xil-se/xilwatch_hw/xilwatch2.pdf

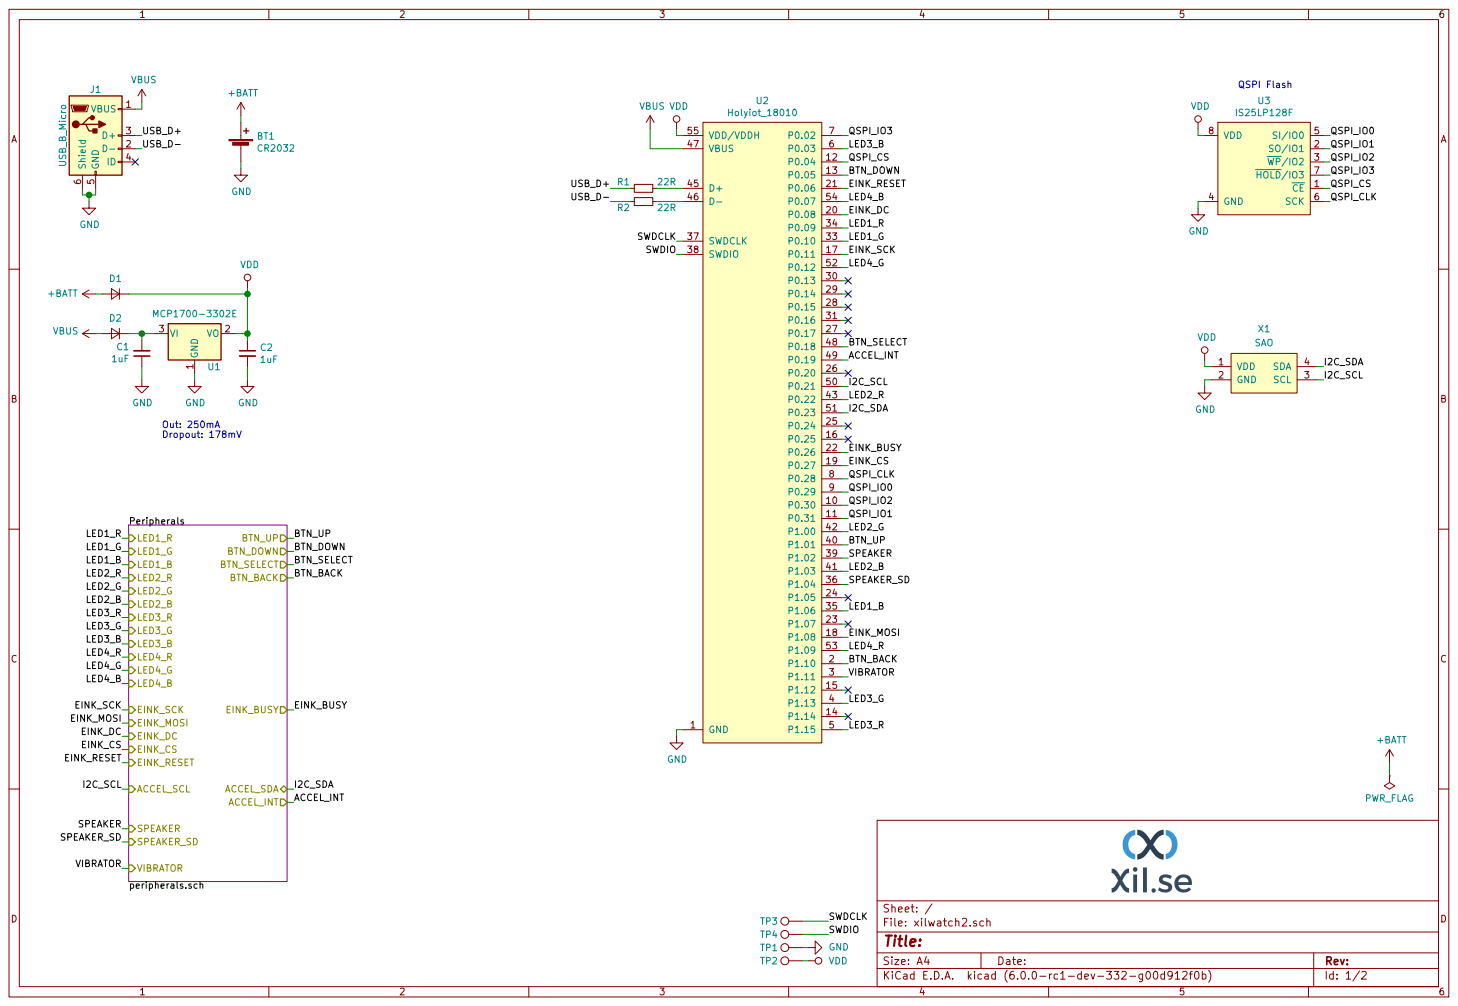
[picture p1: page 1]

Id: 1/2 Title: File: xilwatch2.sch Sheet: / VDD GND
SWDCLK
SWDIO

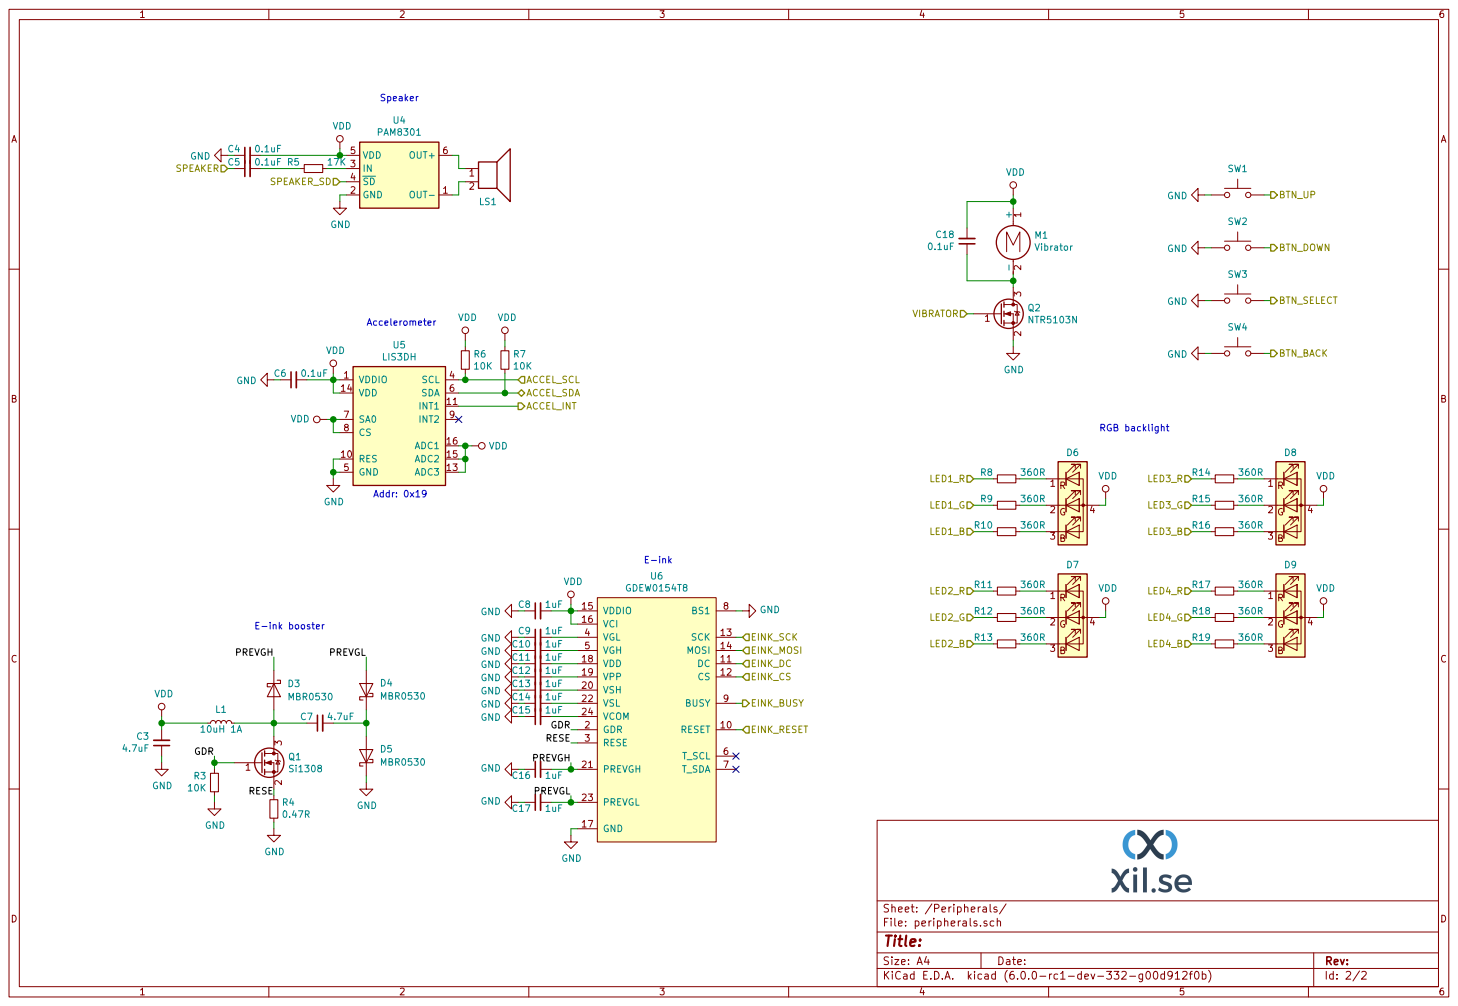
[picture p2: page 2]
