xil-se/xilwatch_hw/xilwatch2.kicad_pcb

## KiCad design xilwatch2.kicad_pcb (2018-09-23)

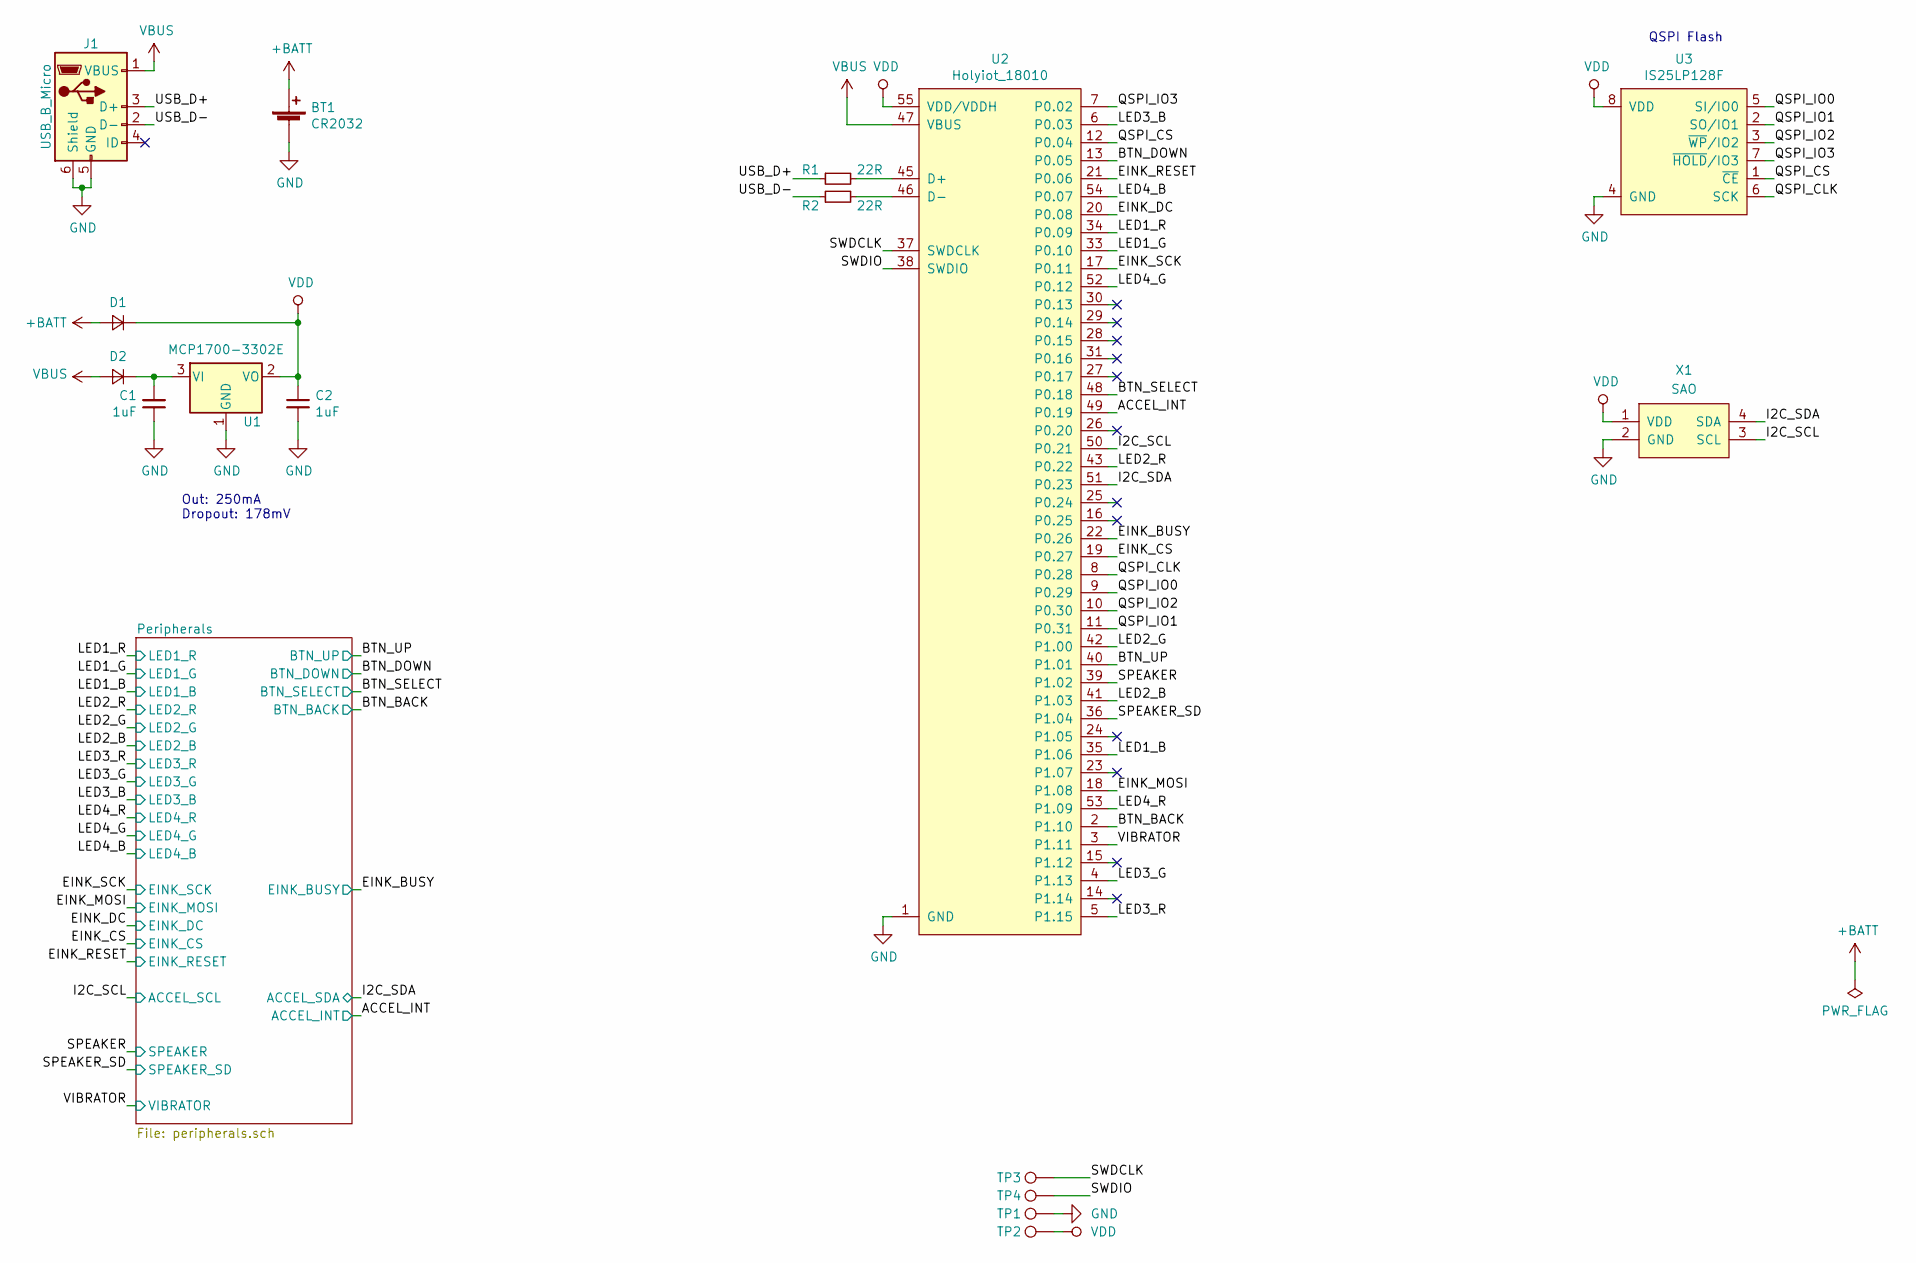
[picture p3: schematic xilwatch2.sch]

Parts:
BT1: CR2032; BAT-HLD-001
C1, C2: 1uF; C_0603_1608Metric
D1, D2: S1JHE; D_SOD-323F
J1: USB_B_Micro; USB_Micro-B_Molex-105017-0001
R1, R2: 22R; R_0603_1608Metric
TP1: TP_GND; TestPoint_Pad_D1.0mm
TP2: TP_VDD; TestPoint_Pad_D1.0mm
TP3: TP_SWDCLK; TestPoint_Pad_D1.0mm
TP4: TP_SWDIO; TestPoint_Pad_D1.0mm
U1: MCP1700-3302E; SOT-23
U2: Holyiot_18010
U3: IS25LP128F; WSON-8-1EP_6x5mm_P1.27mm_EP3.4x4mm
X1: SAO; SAO-2x2

Connections:
+BATT: BT1.1 (+), D1.2 (A)
/ACCEL_INT: U2.49 (P0.19); also elsewhere on the board
/BTN_BACK: U2.2 (P1.10); also elsewhere on the board
/BTN_DOWN: U2.13 (P0.05); also elsewhere on the board
/BTN_SELECT: U2.48 (P0.18); also elsewhere on the board
/BTN_UP: U2.40 (P1.01); also elsewhere on the board
/EINK_BUSY: U2.22 (P0.26); also elsewhere on the board
/EINK_CS: U2.19 (P0.27); also elsewhere on the board
/EINK_DC: U2.20 (P0.08); also elsewhere on the board
/EINK_MOSI: U2.18 (P1.08); also elsewhere on the board
/EINK_RESET: U2.21 (P0.06); also elsewhere on the board
/EINK_SCK: U2.17 (P0.11); also elsewhere on the board
/I2C_SCL: U2.50 (P0.21), X1.3 (SCL); also elsewhere on the board
/I2C_SDA: U2.51 (P0.23), X1.4 (SDA); also elsewhere on the board
/LED1_B: U2.35 (P1.06); also elsewhere on the board
/LED1_G: U2.33 (P0.10); also elsewhere on the board
/LED1_R: U2.34 (P0.09); also elsewhere on the board
/LED2_B: U2.41 (P1.03); also elsewhere on the board
/LED2_G: U2.42 (P1.00); also elsewhere on the board
/LED2_R: U2.43 (P0.22); also elsewhere on the board
/LED3_B: U2.6 (P0.03); also elsewhere on the board
/LED3_G: U2.4 (P1.13); also elsewhere on the board
/LED3_R: U2.5 (P1.15); also elsewhere on the board
/LED4_B: U2.54 (P0.07); also elsewhere on the board
/LED4_G: U2.52 (P0.12); also elsewhere on the board
/LED4_R: U2.53 (P1.09); also elsewhere on the board
/QSPI_CLK: U2.8 (P0.28), U3.6 (SCK)
/QSPI_CS: U2.12 (P0.04), U3.1 (~CE~)
/QSPI_IO0: U2.9 (P0.29), U3.5 (SI/IO0)
/QSPI_IO1: U2.11 (P0.31), U3.2 (SO/IO1)
/QSPI_IO2: U2.10 (P0.30), U3.3 (~WP~/IO2)
/QSPI_IO3: U2.7 (P0.02), U3.7 (~HOLD~/IO3)
/SPEAKER: U2.39 (P1.02); also elsewhere on the board
/SPEAKER_SD: U2.36 (P1.04); also elsewhere on the board
/SWDCLK: TP3.1, U2.37 (SWDCLK)
/SWDIO: TP4.1, U2.38 (SWDIO)
/USB_D+: J1.3 (D+), R1.1
/USB_D-: J1.2 (D-), R2.1
/VIBRATOR: U2.3 (P1.11); also elsewhere on the board
GND: BT1.2 (-), C1.1, C2.2, J1.5 (GND), J1.6 (Shield), TP1.1, U1.1 (GND), U2.1 (GND), U2.32 (GND), U2.44 (GND), U3.4 (GND), U3.9 (GND), X1.2 (GND); also elsewhere on the board
unnamed: C1.2, D2.1 (K), U1.3 (VI)
unnamed: R1.2, U2.45 (D+)
unnamed: R2.2, U2.46 (D-)
VBUS: D2.2 (A), J1.1 (VBUS), U2.47 (VBUS)
VDD: C2.1, D1.1 (K), TP2.1, U1.2 (VO), U2.55 (VDD/VDDH), U3.8 (VDD), X1.1 (VDD); also elsewhere on the board

Notes on the sheet:
Out: 250mA Dropout: 178mV
QSPI Flash

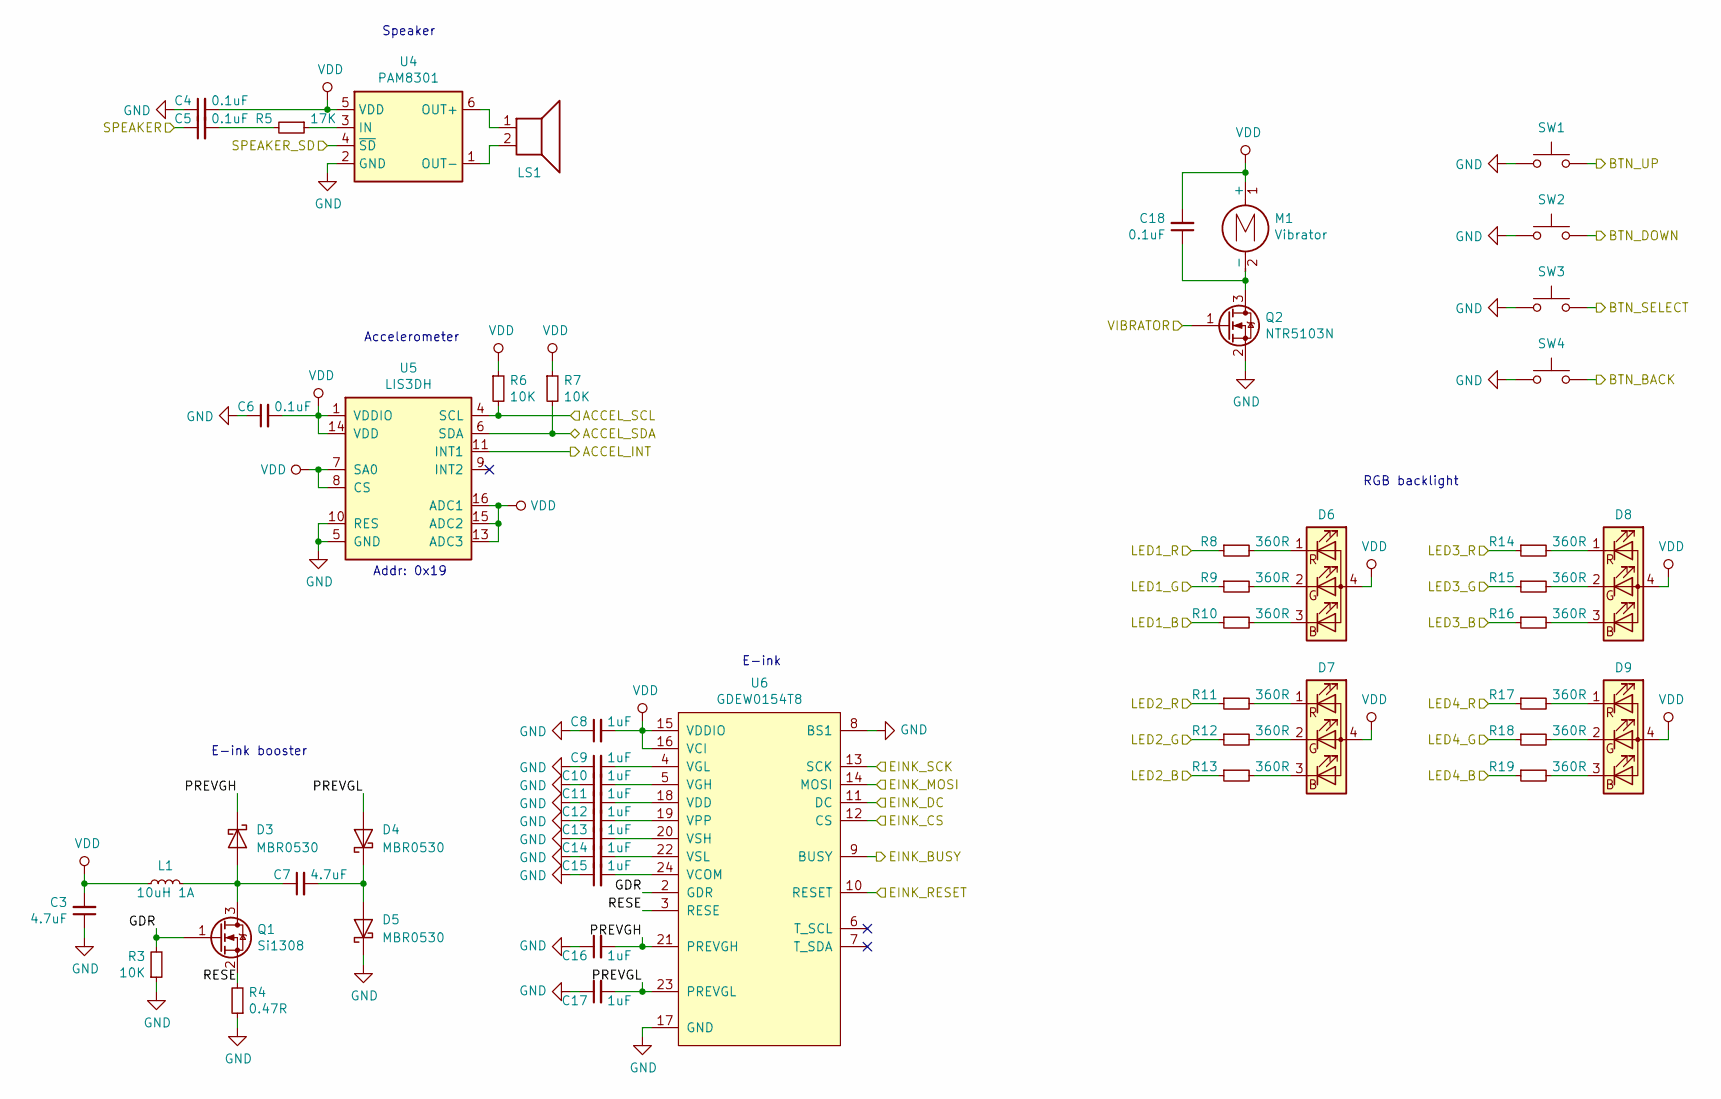
[picture p4: schematic peripherals.sch]

Parts:
C3, C7: 4.7uF; C_0603_1608Metric
C4, C5, C6, C18: 0.1uF; C_0603_1608Metric
C8, C9, C10, C11, C12, C13, C14, C15, C16, C17: 1uF; C_0603_1608Metric
D3, D4, D5: MBR0530; D_SOD-123
D6: LED_TopLeft; LED_RGBA_0606
D7: LED_TopRight; LED_RGBA_0606
D8: LED_BottomLeft; LED_RGBA_0606
D9: LED_BottomRight; LED_RGBA_0606
L1: 10uH 1A; L_Taiyo-Yuden_MD-3030; Part AISC-1210HS-100K-T2
LS1: CMT-5023S-SMT; CMT-5023S
M1: Vibrator; C1026B
Q1: Si1308; SOT-23
Q2: NTR5103N; SOT-23
R3, R6, R7: 10K; R_0603_1608Metric
R4: 0.47R; R_0603_1608Metric
R5: 17K; R_0603_1608Metric
R8, R9, R10, R11, R12, R13, R14, R15, R16, R17, R18, R19: 360R; R_0603_1608Metric
SW1: Btn_Up; KLS7-TS2402
SW2: Btn_Down; KLS7-TS2402
SW3: Btn_Select; KLS7-TS2402
SW4: Btn_Back; KLS7-TS2402
U4: PAM8301; SOT-23-6
U5: LIS3DH; LGA-16_3x3mm_P0.5mm_LayoutBorder3x5y
U6: GDEW0154T8; GoodDisplay_24P-0.5SH_1x24-Horizontal

Connections:
/ACCEL_INT: U5.11 (INT1); also elsewhere on the board
/BTN_BACK: SW4.2; also elsewhere on the board
/BTN_DOWN: SW2.2; also elsewhere on the board
/BTN_SELECT: SW3.2; also elsewhere on the board
/BTN_UP: SW1.2; also elsewhere on the board
/EINK_BUSY: U6.9 (BUSY); also elsewhere on the board
/EINK_CS: U6.12 (CS); also elsewhere on the board
/EINK_DC: U6.11 (DC); also elsewhere on the board
/EINK_MOSI: U6.14 (MOSI); also elsewhere on the board
/EINK_RESET: U6.10 (RESET); also elsewhere on the board
/EINK_SCK: U6.13 (SCK); also elsewhere on the board
/I2C_SCL: R6.2, U5.4 (SCL); also elsewhere on the board
/I2C_SDA: R7.2, U5.6 (SDA); also elsewhere on the board
/LED1_B: R10.1; also elsewhere on the board
/LED1_G: R9.1; also elsewhere on the board
/LED1_R: R8.1; also elsewhere on the board
/LED2_B: R13.1; also elsewhere on the board
/LED2_G: R12.1; also elsewhere on the board
/LED2_R: R11.1; also elsewhere on the board
/LED3_B: R16.1; also elsewhere on the board
/LED3_G: R15.1; also elsewhere on the board
/LED3_R: R14.1; also elsewhere on the board
/LED4_B: R19.1; also elsewhere on the board
/LED4_G: R18.1; also elsewhere on the board
/LED4_R: R17.1; also elsewhere on the board
/Peripherals/GDR: Q1.1 (G), R3.2, U6.2 (GDR)
/Peripherals/PREVGH: C16.2, D3.1 (K), U6.21 (PREVGH)
/Peripherals/PREVGL: C17.2, D4.2 (A), U6.23 (PREVGL)
/Peripherals/RESE: Q1.2 (S), R4.2, U6.3 (RESE)
/SPEAKER: C5.1; also elsewhere on the board
/SPEAKER_SD: U4.4 (~SD); also elsewhere on the board
/VIBRATOR: Q2.1 (G); also elsewhere on the board
GND: C3.1, C4.1, C6.1, C8.1, C9.1, C10.1, C11.1, C12.1, C13.1, C14.1, C15.1, C16.1, C17.1, D5.1 (K), Q2.2 (S), R3.1, R4.1, SW1.1, SW2.1, SW3.1, SW4.1, U4.2 (GND), U5.5 (GND), U5.10 (RES), U5.12 (GND), U6.8 (BS1), U6.17 (GND); also elsewhere on the board
unnamed: C5.2, R5.2
unnamed: C7.1, D3.2 (A), L1.1, Q1.3 (D)
unnamed: C7.2, D4.1 (K), D5.2 (A)
unnamed: C9.2, U6.4 (VGL)
unnamed: C10.2, U6.5 (VGH)
unnamed: C11.2, U6.18 (VDD)
unnamed: C12.2, U6.19 (VPP)
unnamed: C13.2, U6.20 (VSH)
unnamed: C14.2, U6.22 (VSL)
unnamed: C15.2, U6.24 (VCOM)
unnamed: C18.1, M1.2 (-), Q2.3 (D)
unnamed: D6.1 (RK), R8.2
unnamed: D6.2 (GK), R9.2
unnamed: D6.3 (BK), R10.2
unnamed: D7.1 (RK), R11.2
unnamed: D7.2 (GK), R12.2
unnamed: D7.3 (BK), R13.2
unnamed: D8.1 (RK), R14.2
unnamed: D8.2 (GK), R15.2
unnamed: D8.3 (BK), R16.2
unnamed: D9.1 (RK), R17.2
unnamed: D9.2 (GK), R18.2
unnamed: D9.3 (BK), R19.2
unnamed: LS1.1, U4.6 (OUT+)
unnamed: LS1.2, U4.1 (OUT-)
unnamed: R5.1, U4.3 (IN)
VDD: C3.2, C4.2, C6.2, C8.2, C18.2, D6.4 (A), D7.4 (A), D8.4 (A), D9.4 (A), L1.2, M1.1 (+), R6.1, R7.1, U4.5 (VDD), U5.1 (VDDIO), U5.7 (SA0), U5.8 (CS), U5.13 (ADC3), U5.14 (VDD), U5.15 (ADC2), U5.16 (ADC1), U6.15 (VDDIO), U6.16 (VCI); also elsewhere on the board

Notes on the sheet:
Speaker
E-ink
E-ink booster
Accelerometer
RGB backlight
Addr: 0x19

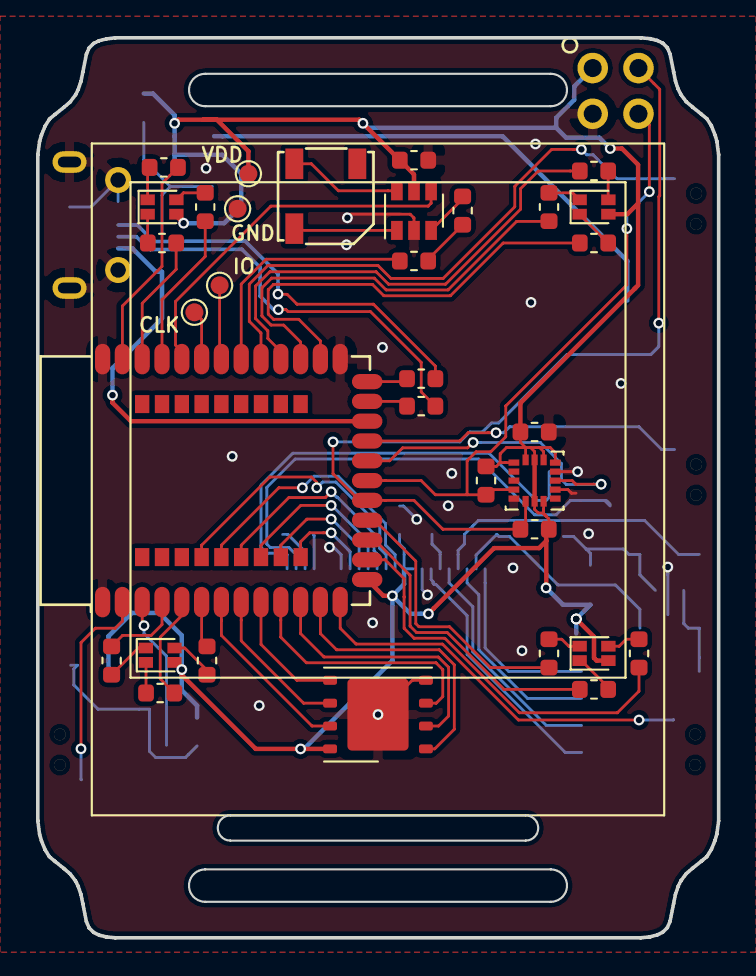
[picture p5: board xilwatch2.kicad_pcb from above]

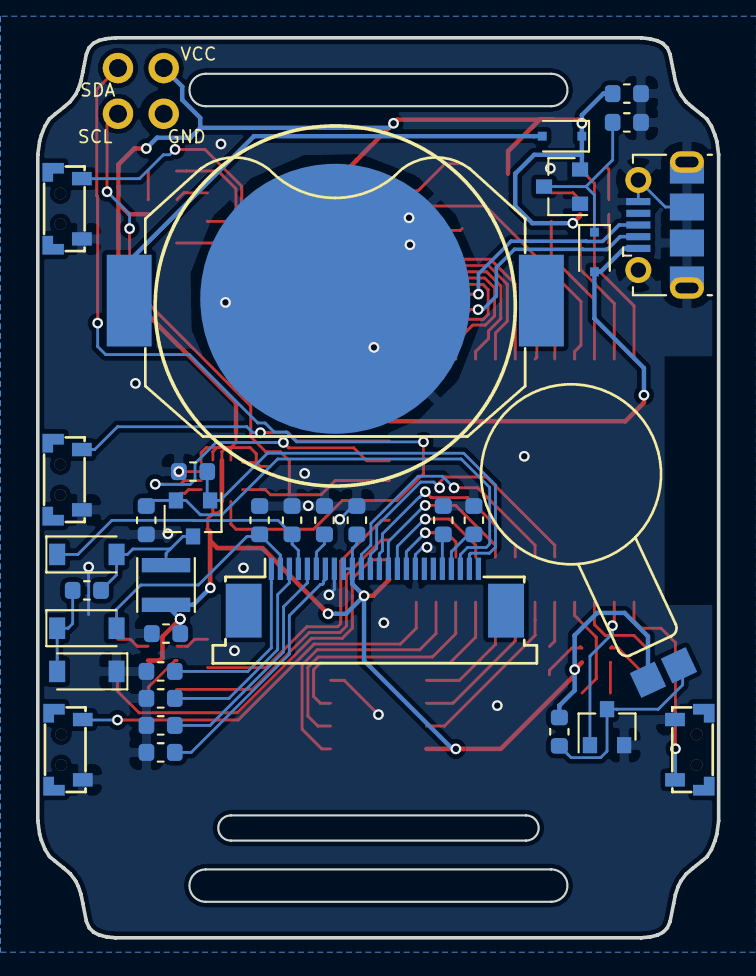
[picture p6: board xilwatch2.kicad_pcb from below]

Board: 2 copper layers, 37.8 x 50.0 mm, 68 parts (34 on the bottom side), 75 nets.
