xil-se/xilwatch_hw/(commit log)

2018-09-14 Initial import
    [xilwatch2.kicad_pcb, xilwatch2.sch]
2018-09-14 More work, mostly copied from rev1
    [xilwatch2.sch]
2018-09-14 Finish power, usb, replace accel, add flash and assign footprints
    [xilwatch2.sch]
2018-09-17 Finish up the schematic
    [peripherals.sch, power.sch]
2018-09-18 Change of plans, now a nRF52840 with E-ink
    [peripherals.sch, power.sch, xilwatch2.kicad_pcb, xilwatch2.sch]
2018-09-23 Finish rev1
    [peripherals.sch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]
